alantomjose/Fire-Alarm-System-8086-Proteus/MUP REPORT G106.pdf

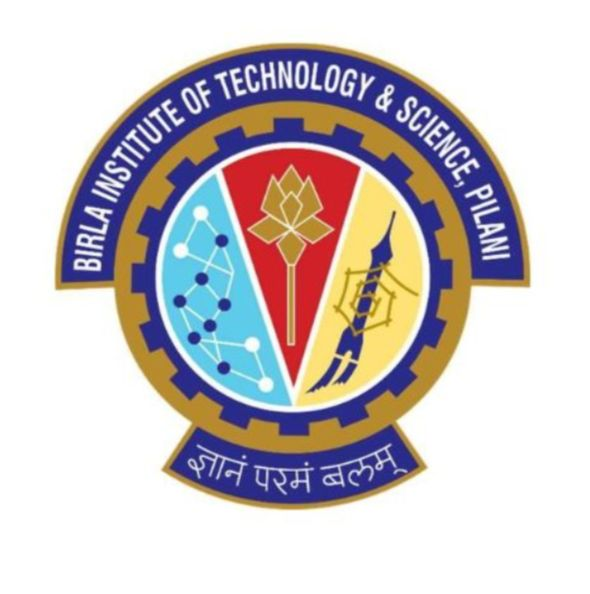
[picture p1: figure]

### Microprocessors and Interfacing

# Fire Alarm System

G-106

## Members:

Alan Tom Jose: 2018A7PS0187G

Aanand S J: 2018A7PS0139G

Prajval M: 2018A3PS0299G

Ajay James Alex: 2018A7PS0633G

Madhav M Anand: 2018A8PS0028G

## Contents

Description & Technical Specifications | 3
Assumptions & Justifications | 4
Components used | 5
Memory Organisation | 6
I/O Based Memory Map | 8
Other Devices | 9
Design | 10
Flow Chart | 18
Main Program | 18
Interrupt Timer ISR | 19
ADC ISR | 20
MAlfunction | 20
Variations in Proteus Implementation with Justification | 21
Firmware | 10
List of Attachments | 11

## Description of System

This system checks for abnormal smoke content in a room and under such conditions throws open all exit doors and windows and opens a valve that releases the gas to put-out the fire. An Alarm is also sounded; this alarm is sounded until the smoke level in the room drops to an acceptable level. The room has two doors and four windows. The smoke detection system is made up of three smoke sensors placed on the ceiling of the room. When at least two of three detectors get turned on, the alarm system is activated. If only one of them is activated a different alarm sound is produced indicating probable malfunction of alarm. The system can be activated or deactivated using a single switch. .

### Specifications of the problem:

1. The system can be activated/deactivated by a single switch.
2. Three smoke detecting sensors are placed in the ceiling which detect the smoke content in the room.
3. A fire alarm that is sounded when smoke exceeds normal levels for at least two sensors.
4. Two doors, four windows and valves are controlled by motors.
5. The motors and alarms are activated only when two of three sensors detect an abnormal level in smoke levels.
6. If one of them is activated, a single alarm is sounded.

## Assumptions & Justifications

1. Clockwise direction closes all doors, valves and windows and anticlockwise direction opens all doors, valves and windows.
2. We are using MC145010 as the smoke sensor. The IC is used with an infrared photoelectric chamber and detection is accomplished by sensing scattered light from minute smoke particles or other aerosols. The output of the smoke sensor ranges from 0V to 5V. An ADC connected to variable voltage source is used in the design to model the output of the smoke sensor.
3. We have interfaced memory as follows:

ROM1 – 00000H – 00FFFH

ROM2 – FF000H – FFFFFH

RAM 1– 01000H – 01FFFH

4. When we power on the system, all the doors, windows and valve are closed by passing the appropriate control signals through PPI. After this, interrupts are continuously raised to measure the sensor outputs. If both the sensors exceed a threshold value then only doors, windows and valves are opened. In addition to this, an alarm is also sounded.
5. As long as both the sensors are above threshold value, all the doors, windows and valve will remain open. If any sensor falls below the threshold value then close all the doors, windows and valve and alarm is also turned off.

6. The opening of all doors, windows and valves is controlled by a stepper motor which operates in steps with the use of gears. A stepper motor can be programmed to stop rotating after a certain number of steps, which can be programmed through our code.

Components used:

- 6116 (RAM) | – 2 units used
- 2716 (ROM) | – 4 units used
- ADC0808 (1 unit):
– 8-bit ADC
– 8 channel
– 1 MHz clock input
– Resolution 19.5 mV
- 8254 (Programmable interval timer)
– 24 pin IC
- 8255 (Programmable Peripheral Interface (PPI) chip) – Contains three 8-bit ports.
– 24 input/output pins.
– Port A has input lines
– Port B and port C (upper and lower) are output lines
- 8259( Programmable Interrupt Controller) – Interrupt generated at interval of 0.1 seconds.

- 8086(Microprocessor)
– Operating Clock Speed – 5MHz
– 40 pins
– 20 de-multiplexed Address Lines and 16 de-multiplexed Data lines
- 74LS373(octal latch)
– 3 Latches used
- 74LS245 (Octal Bus Transmitter/Receiver) – 2 units used
- 74LS244 (Unidirectional Octal Buffer) – 1 units used
- 74LS04 (Hex inverter) – 2 not gates used.
- 74LS32 (OR Gate IC) – 8 OR Gates used
- L297 (Stepper motor controller): Signals from your microprocessor and translates them into stepping signals to send to the L298
- L298 (Motor driver)
– Drives the stepper motor
– 4 output pins connected to one motor
- Smoke Sensor MC145010
– Used with an infrared photoelectric chamber

## Memory Organization:

Total RAM used by system = 4KB (2 Nos)

Total ROM chips used by system = 8KB (4Nos)

RAM chip used = 6116.

ROM chip used =2716

RAM

Starting address of RAM = 01000 | H
Ending address of RAM = 01FFF | H.

Total 4KB

EvenBankofRAM=01000 | H,01002 | H, 01004 | H, 01006 | H, | ,01FFE | H.
OddBankofRAM=01001 | H,01003 | H, 01005 | H, 01007 | H, | ,01FFF | H.

RAM used to house the data segment and stack segment.

ROM

Starting address of ROM1 = 00000 | H
Ending address of ROM1 = 00FFF | H.

Total 4KB

EvenBankofR0M1=00000 | H,00002 | H, 00004 | H, 00006 | H, | ,00FFE | H.
OddBankofR0M1=00001 | H,00003 | H, 00005 | H, 00007 | H, | ,00FFF | H.
Starting address of ROM2 = FF000 | H
Ending address of ROM2 = FFFFF | H.

Total 4KB

EvenBankofR0M2=FF000 | H,FF002 | H, FF004 | H, FF006 | H, | ,FFFFEH.
OddBankofR0M2=FF001 | H,FF003 | H, FF005 | H, FF007 | H, | ,FFFFFH.

ROM used to house the code segment .It depends on the size of the program.

### (C)IO BASED MEMORY MAPPING:

- 8255 Programmable Peripheral Interface:

One 8255(Programmable Peripheral Interface) are used to communicate with other input and output devices. It is organized in the following manner.

PORT A: 00H

PORT B: 02H

PORT A: 04H

CONTROL REGISTER: 06H

- 8253 Programmable Interval Timer

We need to check values from sensors every 0.1 second. For this we need a timer and hence we are using 8253. It is organized in the following way:

TIMER A: 08H

TIMER B: 0AH

TIMER A: 0CH

CONTROL REGISTER: 0EH

- 8259 Interrupt Controller

Used to set interrupts

A0: 10H

A1:12H

## Other Devices

### Stepper motor controller

Stepper motors are DC motors that move in discrete steps. They have multiple coils that are organized in groups called phases.By energizing each phase in sequence the motor will rotate, one step at a time. It converts digital pulses into mechanical shaft rotation. They are low cost, highly reliable and provide high torque at low speeds.

This Stepper motor controller uses the L297 andL298N driver combination; it can be used as stand alone or controlled by a microcontroller. It is designed to accept step pulses at up to 25,000 per second. An on-board step pulse generator can be used if desired (40-650 pps range). Single supply operation is standard.Here we use a voltage of 5 as VCC and 12 at VS in LS298 and a frequency of 10Hz to drive the motor.

### Smoke Sensor

We are using MC145010 as the smoke sensor. The IC is used with an infrared photoelectric chamber and detection is accomplished by sensing scattered light from minute smoke particles or other aerosols. The output of the smoke sensor ranges from 0V to 5V. An ADC connected to a variable voltage source is used in the design to model the output of the smoke sensor.

# DESIGN

- 8086

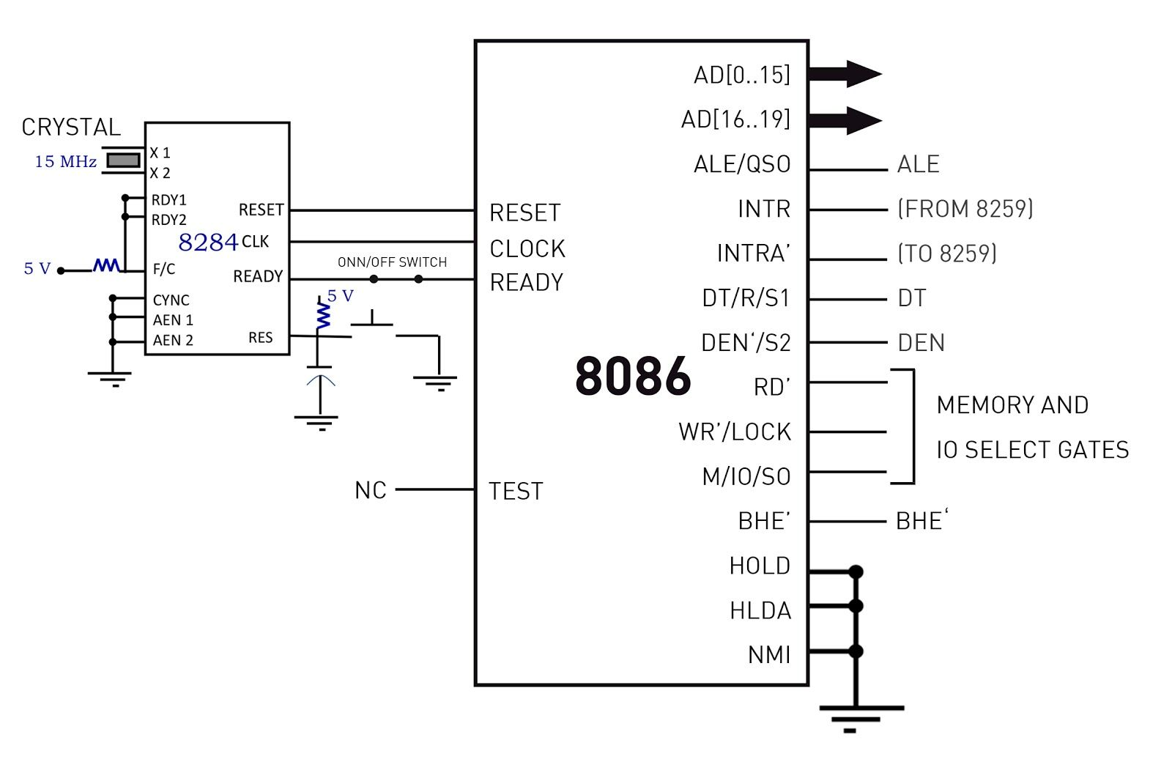
[picture p2: figure]

### - System Bus (Address )

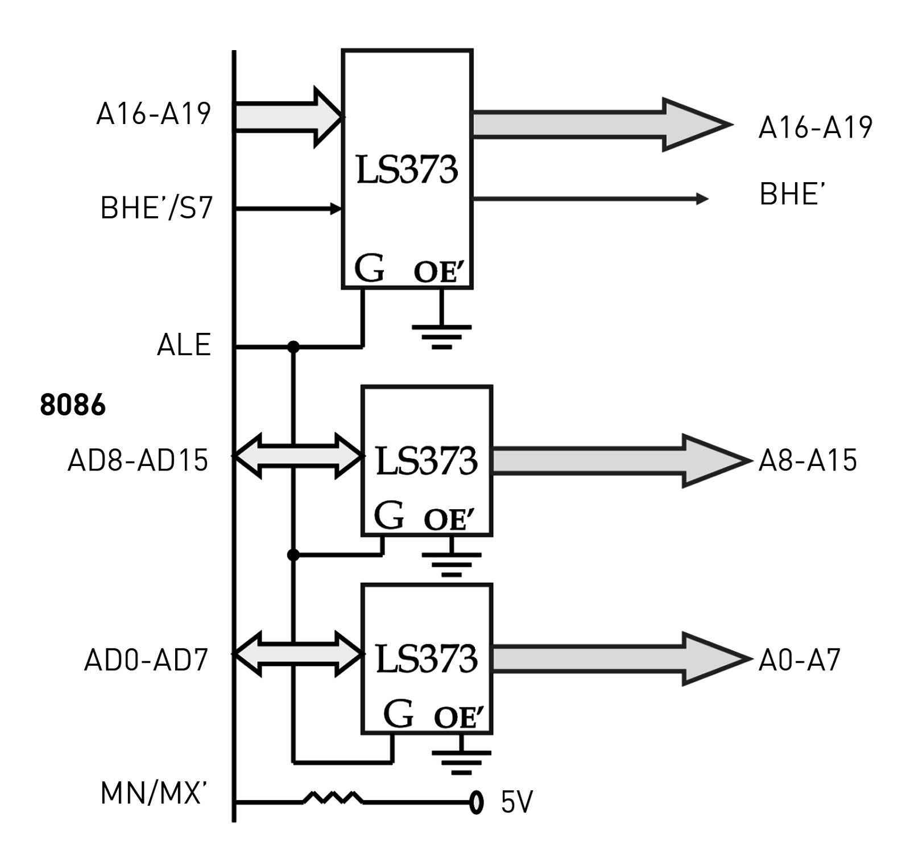
[picture p3: figure]

### - System Bus(Data+Control)

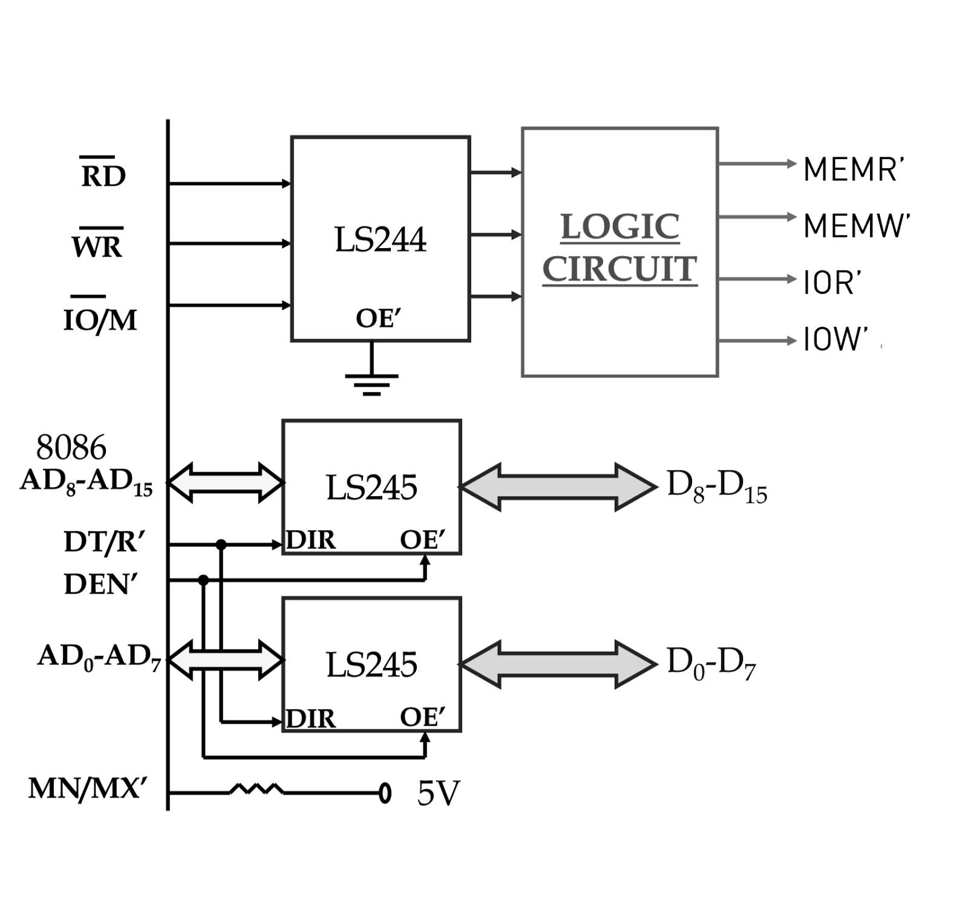
[picture p4: figure]

### I/O and Memory Read Logic

M/IO’ | RD’ | WR’ | Bus Cycle

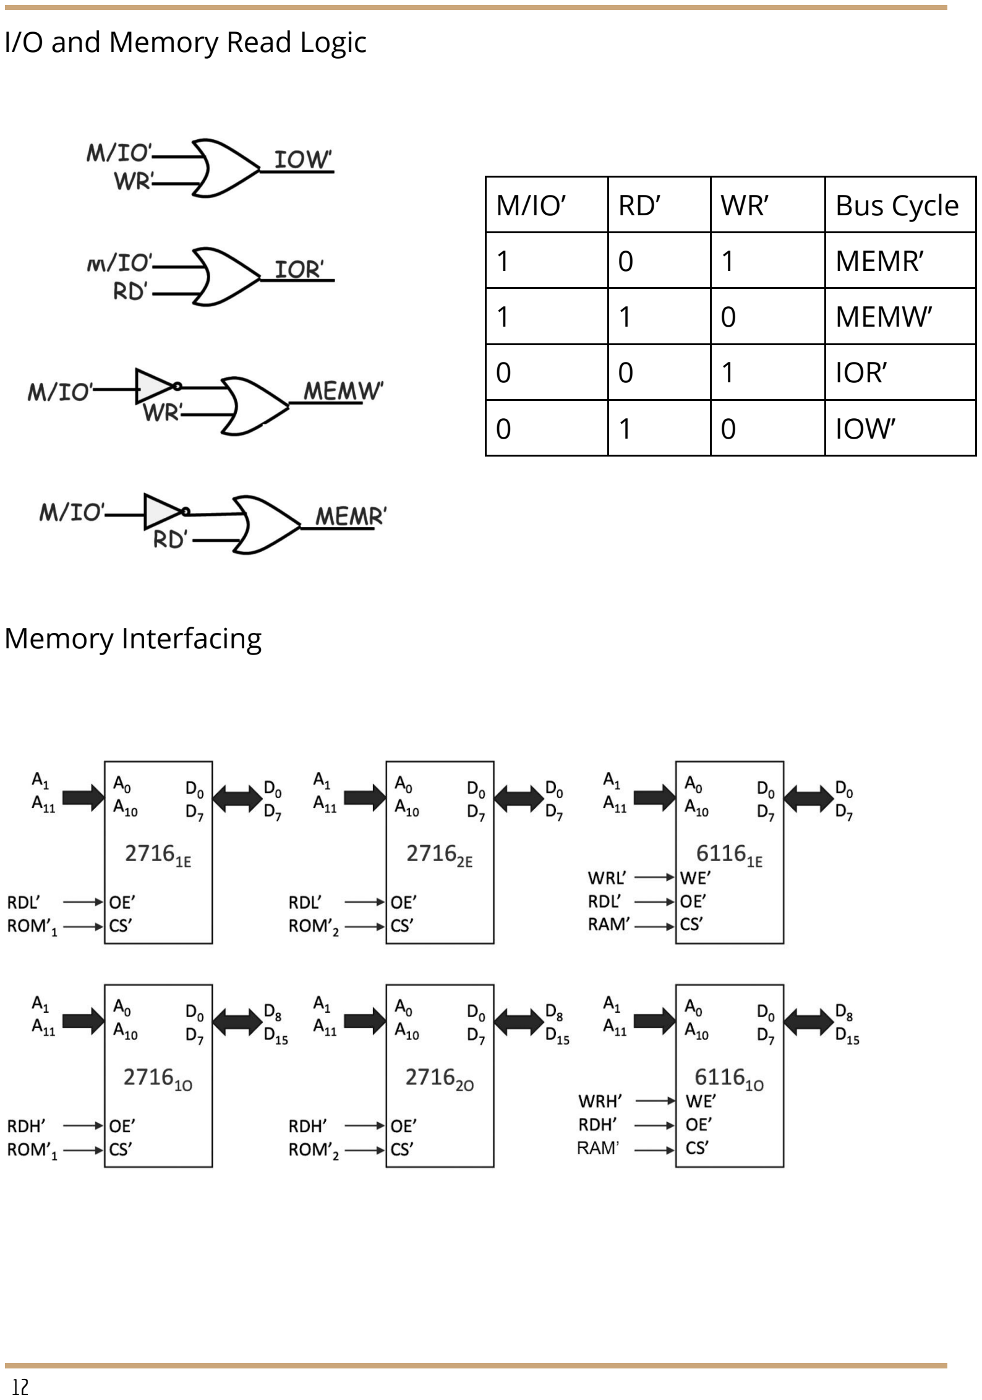
[picture p5: page 12]

1 | 0 | 1 | MEMR’
1 | 1 | 0 | MEMW’
0 | 0 | 1 | IOR’
0 | 1 | 0 | IOW’

### Memory Interfacing

### Memory Decoder

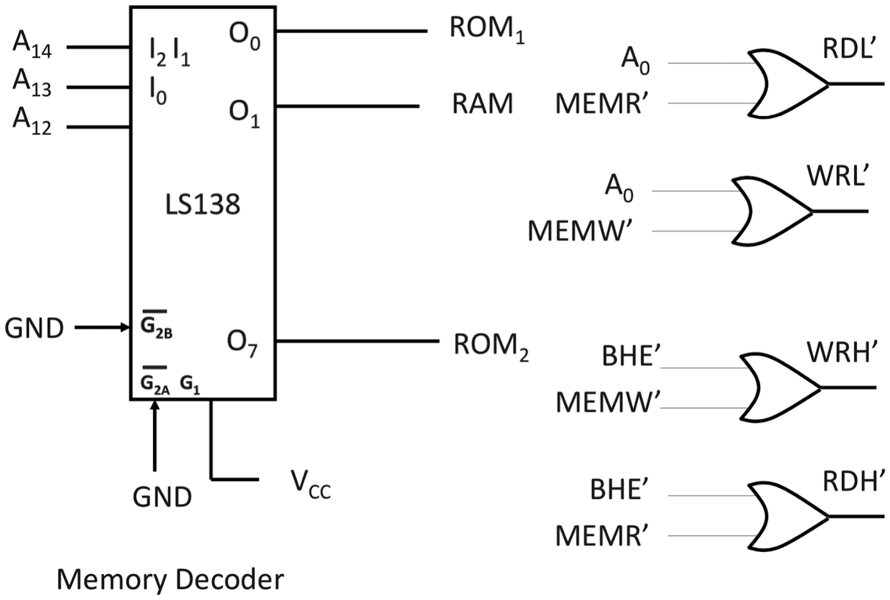
[picture p6: figure]

### I/O Decoder

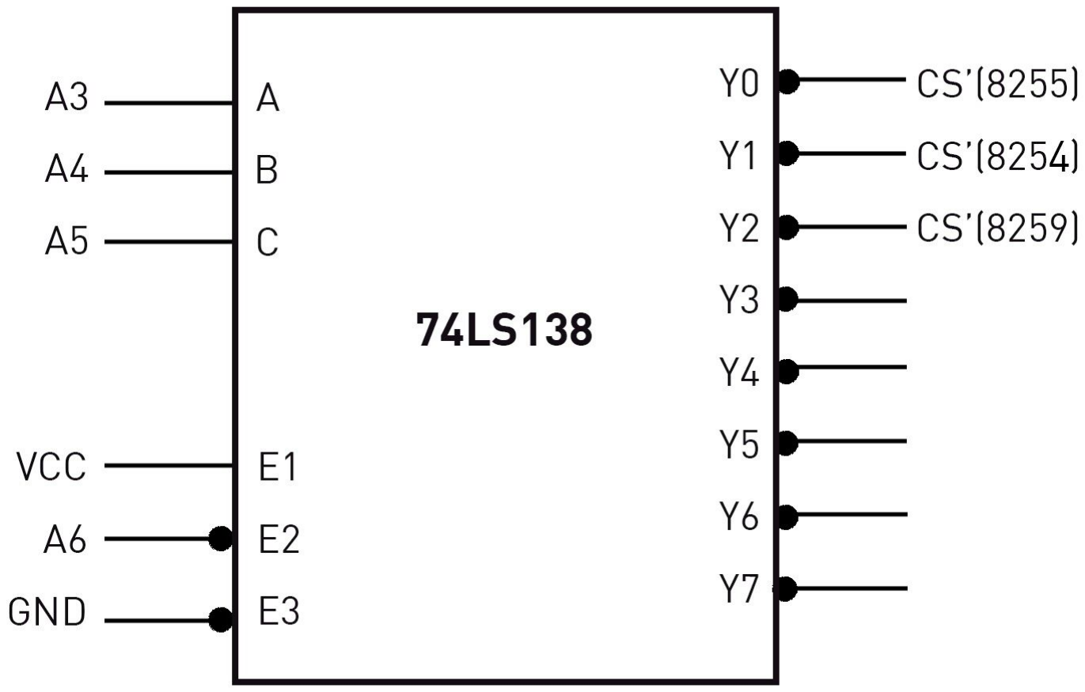
[picture p7: figure]

- 8255

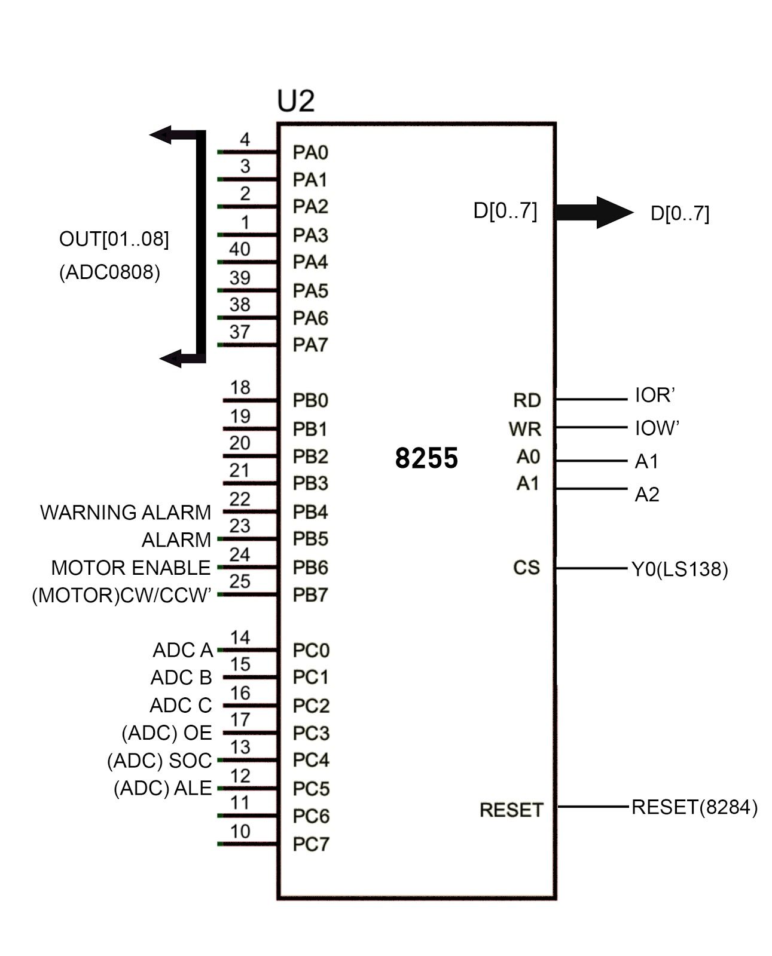
[picture p8: figure]

### - ADC

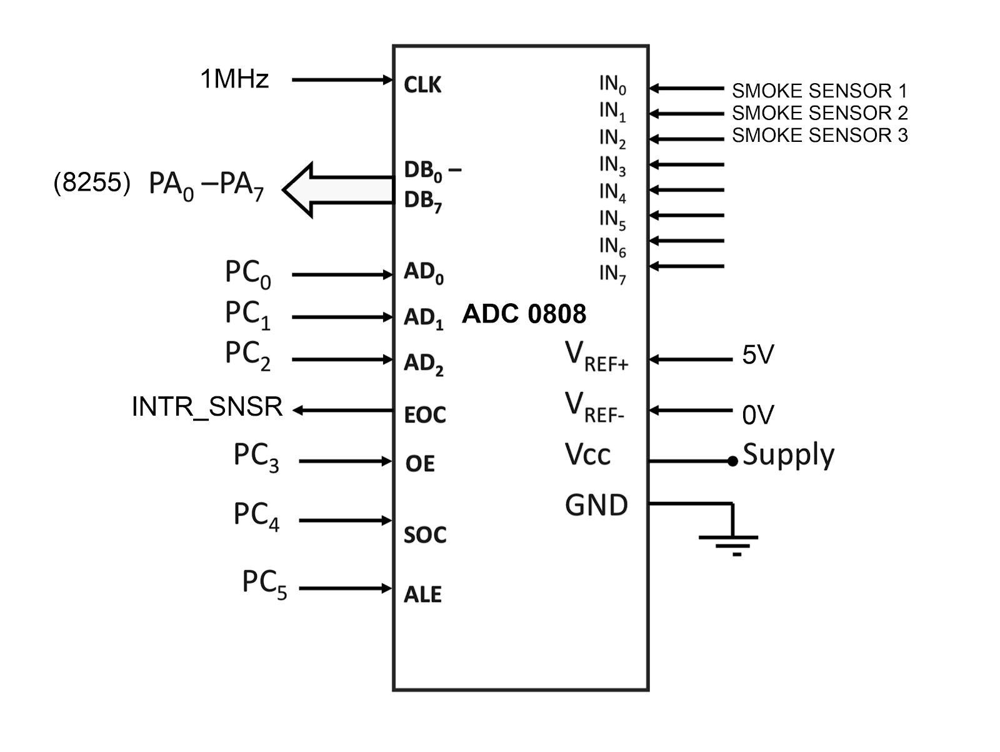
[picture p9: figure]

- 8254

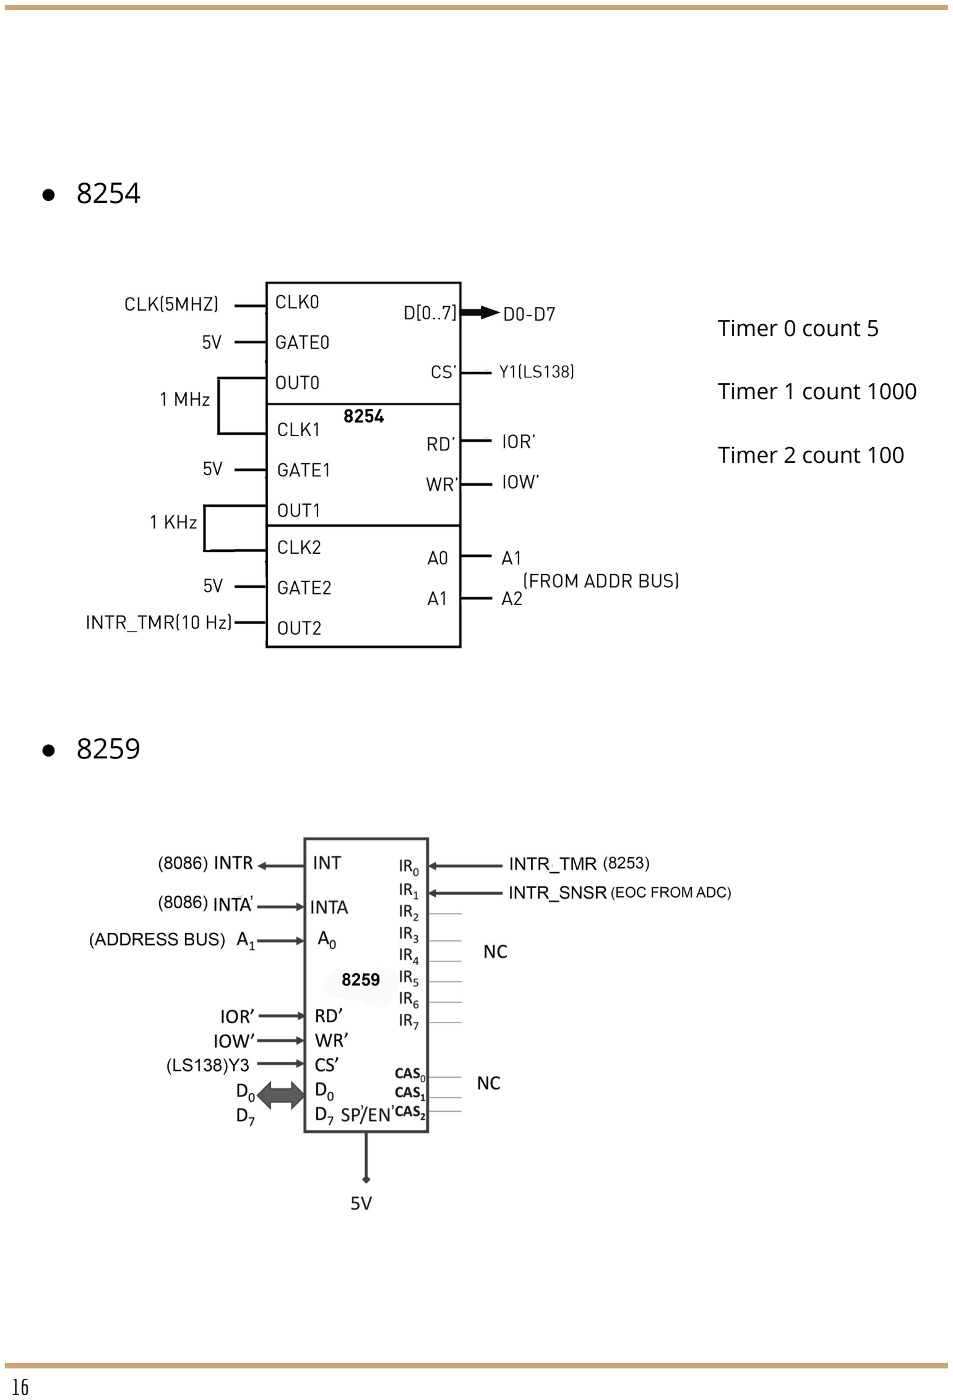
[picture p10: page 16]

Timer 0 count 5

Timer 1 count 1000

Timer 2 count 100

- 8259

### - Stepper Motor (L297,L298)

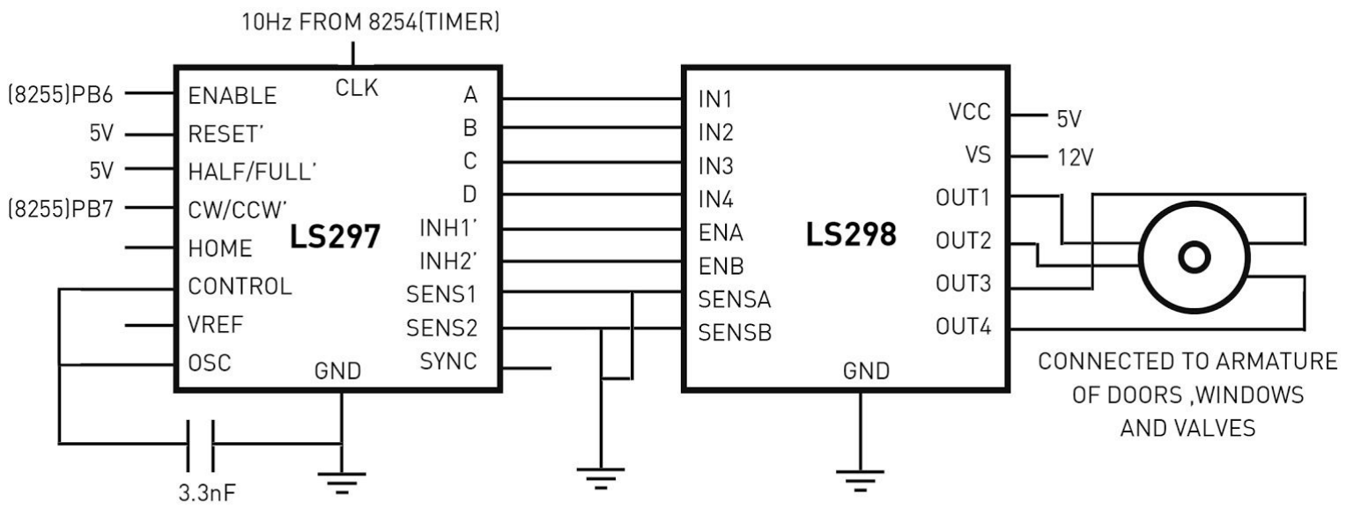
[picture p11: figure]

# FLOWCHART

## - Main

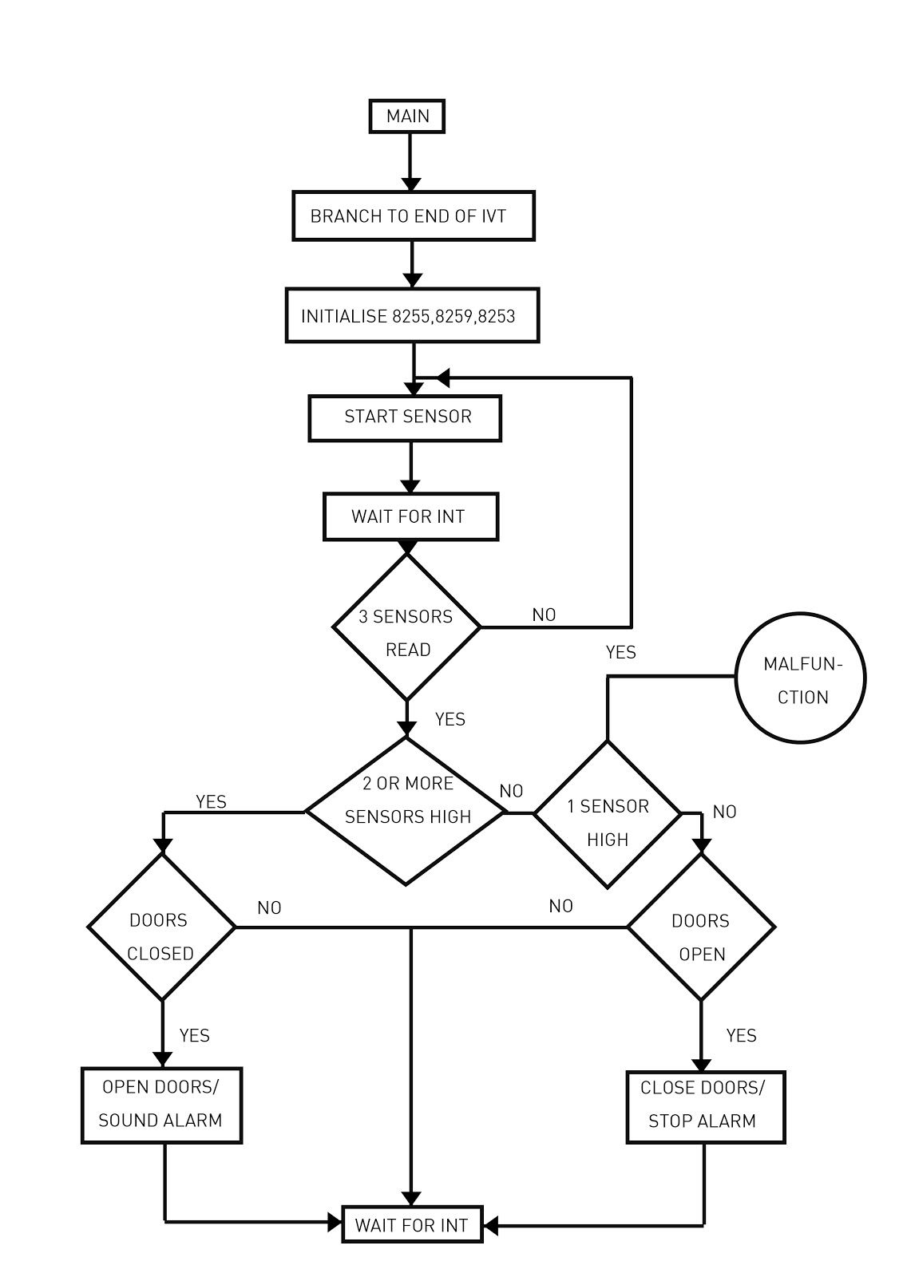
[picture p12: figure]

### - Interrupt timer ISR

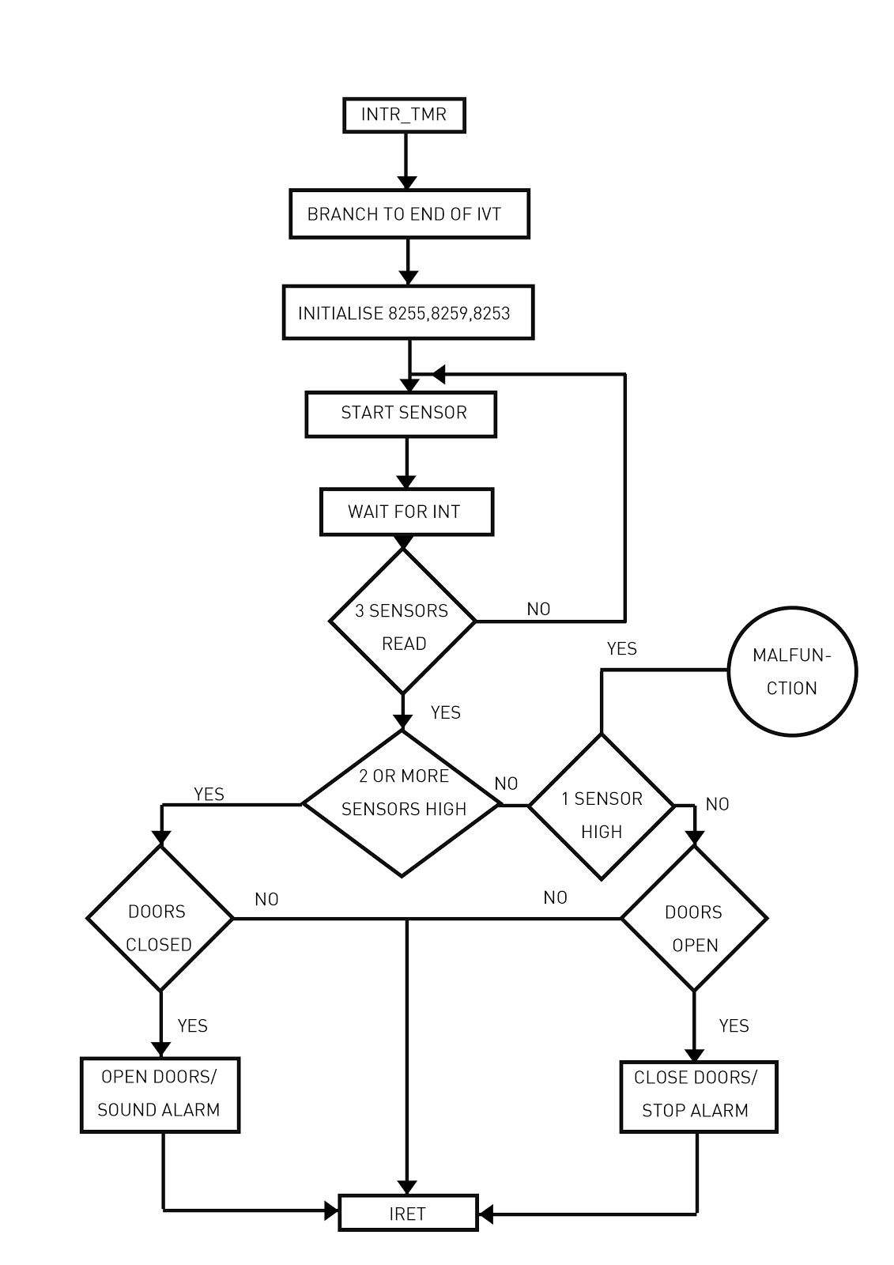
[picture p13: figure]

### - ADC ISR (ISR 2)

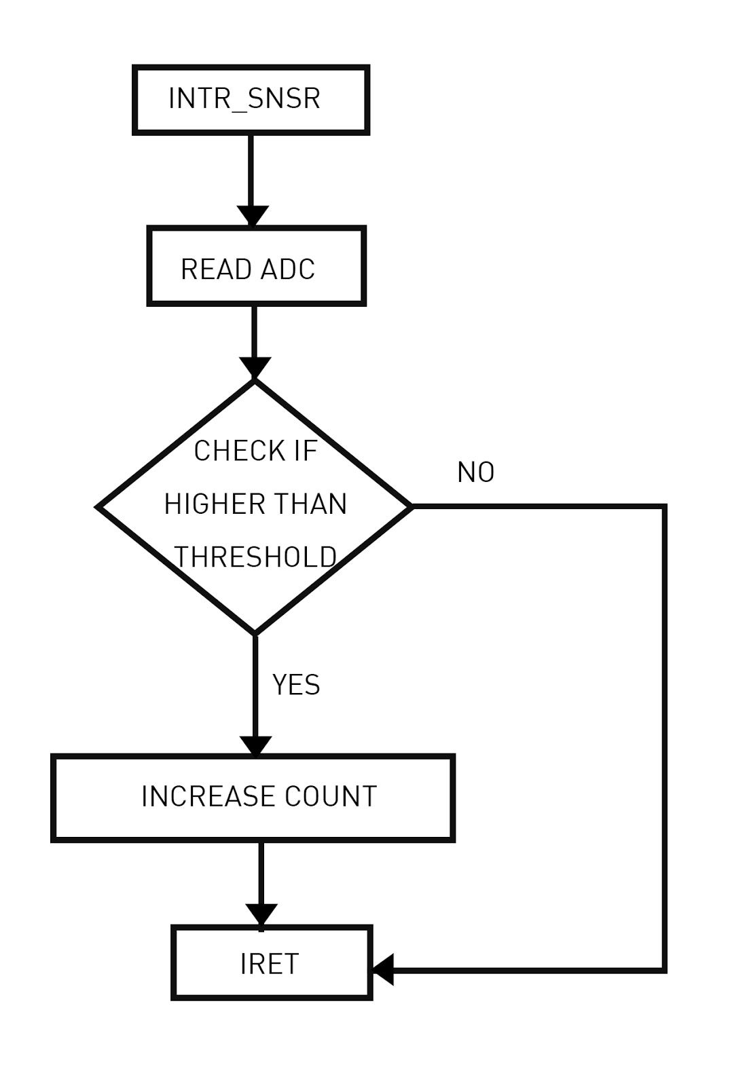
[picture p14: figure]

### - MALFUNCTION

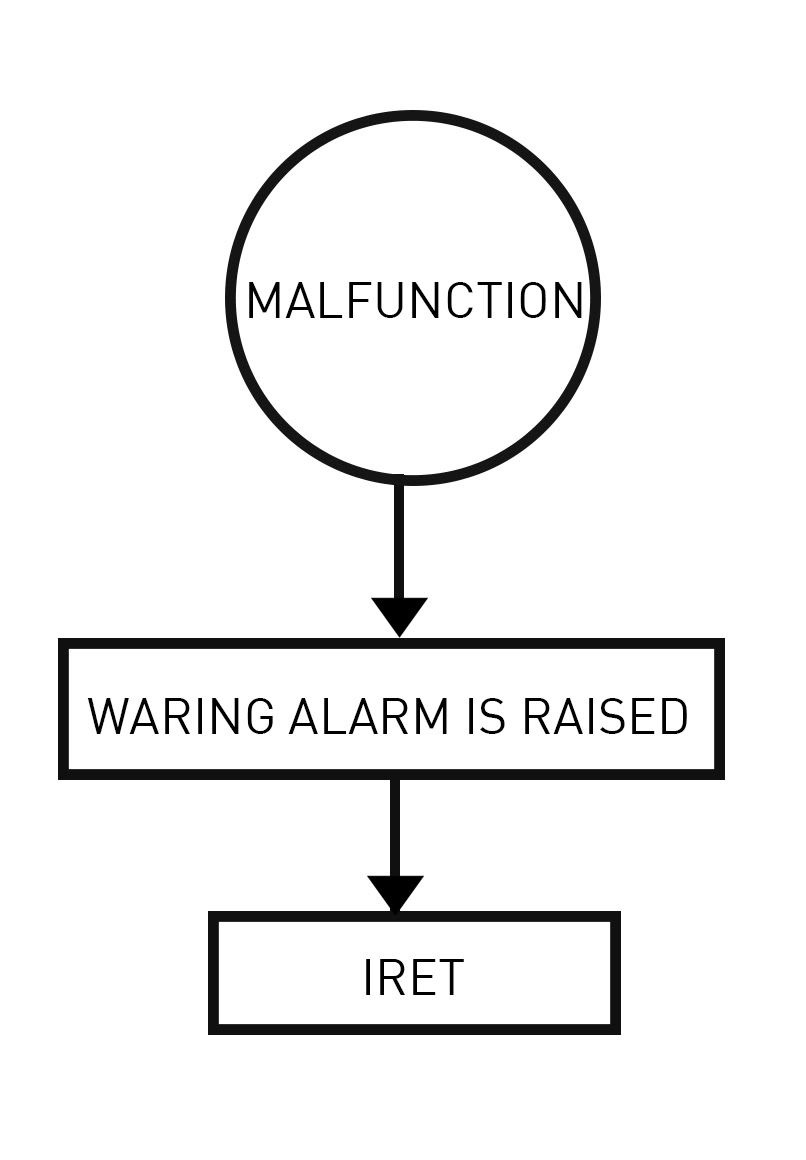
[picture p15: figure]

### Variations in Proteus Implementation with Justification

1. Using 0.1 second delay as 8259 does not work in proteus – EOC is used as NMI and the Timer Int replaced by software delay as 0.1 seconds.
2. The 7 segment display is temporarily kept in design for reference of door stage: 1-for door closed, 0 -for door open.
3. Design also has RED LED to indicate the alarm system is activated and doors are opened. BLUE LED to indicate malfunction when only 1 sensor is activated is also used in design.
4. ROM in only 00000 – as proteus allows to change reset address.
5. Using 8253 – as 8254 not available in Proteus.
6. Clock is at 2 MHz as the clock generated for 8086 requires a long rise and fall time of clock. So ADC clock will be only 500KHz; that is within the 1 MHz max clock that can be provided.
7. 2732 is used as 2716 – not available in Proteus.
8. Using a gate-based circuit for memory – does the same as LS 138 here .
9. Smoke Sensor is replaced by DC voltage (0V-5V) as smoke sensors not available in Proteus.

## Firmware

Implemented using emu8086 attached.

# LIST OF ATTACHMENTS

1. Manuals
a. ADC 0808
b. MC145010
c. L297
d. L298
e. Stepper Motor
f. Alarm
2. Proteus File – alarm.dsn
3. EMU8086 ASM File – firealarm.asm
4. Binary File after assembly – firealarm.bin
