alantomjose/Fire-Alarm-System-8086-Proteus/(list of files, drawings)

Other design files:
alarm.DSN
